brianthornock/KillBox/README.md

# KillBox
A Digital Kill Switch Controller

The Kill Box takes kill switching to the next level. It is digitally controlled and includes features such as:

 - Tap Tempo
 - Pattern Presets
 - Stereo in
 - Dual Mono or true stereo out
