brianthornock/KillBox/KillBox_FullSchematic.png

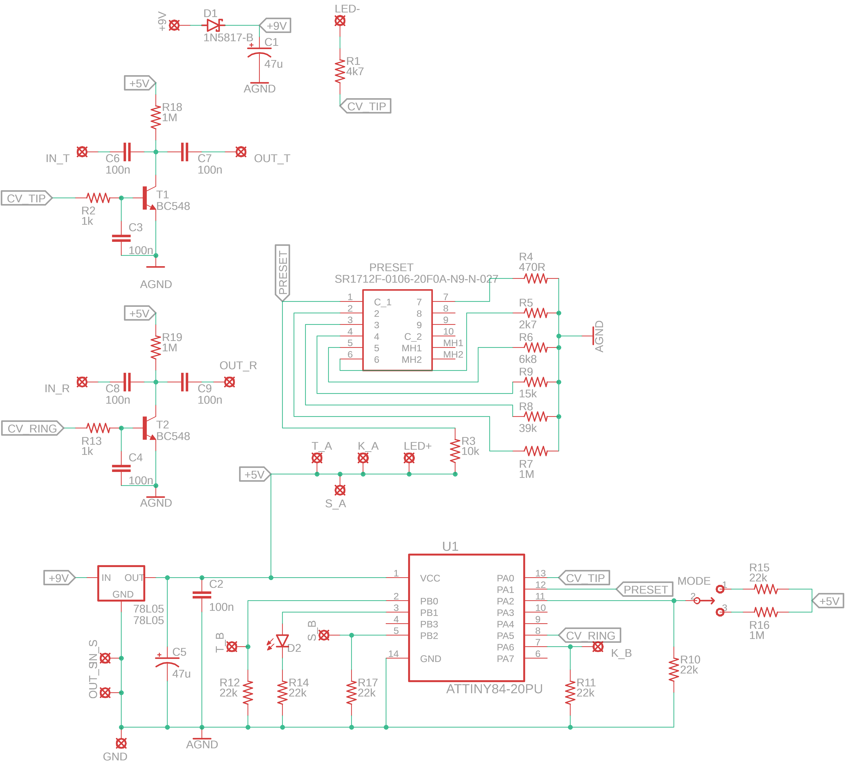
KillBox_FullSchematic.png
