brianthornock/KillBox/(commit log)

2019-03-29 Gerber PCB Files
2019-04-01 Updated silkscreen on Gerber Files
